Manas-Punjabi/rv32i-soc-asic/results/sweep.csv

cell_area_um2 | drc_errors | flow_ok | fmax_mhz_est | hold_ws_ns | mem_sram | mem_words | period_ns | power_w | tns_ns | util | util_target | variant | wirelength_um | wns_ns
1102980.0 | 0 | True | 86.76 | 0.0616165 | 1 | 1024 | 12.0 | 0.047055 | 0 | 0.374041 | 35 | p12p0_u35_sram1024 | 2944982 | 0.474305
1102880.0 | 0 | True | 80.37 | 0.0731262 | 1 | 1024 | 13.0 | 0.0435521 | 0 | 0.374009 | 35 | p13p0_u35_sram1024 | 2921432 | 0.558166
1103110.0 | 0 | True | 75.31 | 0.0297581 | 1 | 1024 | 15.0 | 0.0377121 | 0 | 0.374088 | 35 | p15p0_u35_sram1024 | 2989673 | 1.72226
1104050.0 | 0 | True | 66.54 | -0.0247524 | 1 | 1024 | 20.0 | 0.0288408 | 0 | 0.374405 | 35 | p20p0_u35_sram1024 | 3114832 | 4.97099
