Manas-Punjabi/rv32i-soc-asic/(commit log)

2026-10-10 Add the RV32I core
    Five-stage pipeline with forwarding, a load-use stall and branches
    resolved in execute. Machine-mode traps and interrupts, 64-bit cycle
    and instruction counters, and an RVFI retirement trace for
    simulation only.
    A decoupled fetch front-end keeps two SRAM reads in flight and
    buffers instructions in a three-entry queue, so straight-line code
    runs at one instruction per cycle on synchronous SRAM.
2026-10-10 Add the APB bus, peripherals and accelerator
    APB master and address decoder, a UART, a CLINT-style timer, GPIO
    with synchronized inputs, and the 4x4 matrix-multiply accelerator
    behind an APB register interface. Unmapped accesses return an error
    instead of hanging the bus.
2026-10-10 Add firmware and the accelerator benchmark
    Startup code, linker scripts, the C memory map and a benchmark that
    multiplies the same matrices in software and on the accelerator,
    times both with the on-chip timer and checks the results agree.
2026-10-10 Add testbenches and directed tests
    Core and SoC testbenches that check the RVFI trace on every
    program, testbenches for each peripheral, a cycle-by-cycle
    comparison of the flop and SRAM memory builds, directed tests for
    interrupts, fence.i and every peripheral, and the post-layout
    simulation testbench.
2026-10-10 Add Makefile, test runners and mutation checks
    make verify runs lint, the memory comparison, the peripheral tests,
    the riscv-tests suites on the core (with and without random stalls)
    and on the SoC, and the benchmark, and fails on the first failed
    check. The mutation scripts inject 28 core and 12 peripheral bugs;
    the tests must catch every one.
2026-10-10 Add synchronizer, equivalence and scan checks
    A structural check that every asynchronous input passes through a
    two-flop synchronizer, with six broken synchronizers it must catch;
    per-module equivalence of RTL and synthesized netlist; clock gate
    insertion; and scan chain insertion.
2026-10-10 Add physical design setup for SkyWater 130 nm
    Timing constraints, the OpenROAD flow configuration with two SRAM
    macros, and a power-grid script that connects the macros' supplies.
    The flow runs in a Docker image pinned by digest.
2026-10-10 Add sign-off and analysis scripts
    Static timing at three corners, full-deck DRC with the SRAM macros
    held as the PDK's abstract view, layout versus schematic, post-
    layout simulation with back-annotated delays, results extraction,
    the clock-period sweep with its plot, and a layout render.
2026-10-10 Add sign-off reports and measured results
    Reports from the 15 ns sign-off run: timing at three corners, DRC
    with 0 errors on this design, a layout-versus-schematic match with
    the macros included, and the flow's final metrics. Also the clock
    sweep and the clock-gating and scan variants.
2026-10-10 Add design, verification and implementation docs
    Architecture covers the memory map, register maps, core, memory and
    benchmark. Verification lists every check with its result.
    Implementation covers the physical flow and sign-off. The decisions
    document records the reason behind each design choice.
